Hemanth3247/Vector/Media/Rocket_avionics.jpeg

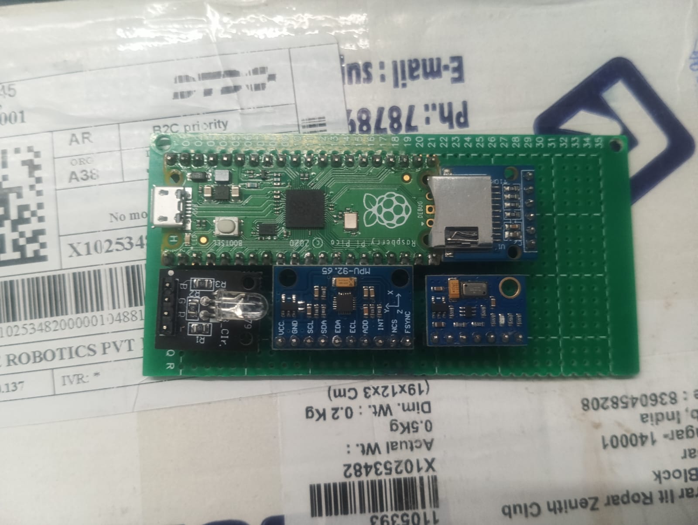
Media/Rocket_avionics.jpeg
