Hemanth3247/Vector/Documentation/Rocket Avionics SystemNew.docx

Rocket Avionics System

Microcontroller

A microcontroller is like the brain of the system it does all the tasks like sensors data reading, logging data, controlling modules, and control actuators. It does all the calculation and computation of the data being received. It integrates all the modules.

For an Avionics system due to multiple sensors and modules integrated we use a microcontroller with good clock speed for fast calculations due to continuous change in data, Hardware compatible since we use so many sensors and modules (We need to use a Microcontroller which supports all I2C,UART,SPI Protocols), good Memory since few modules give huge data, Low power consumption and Size & Weight the avionics system needs to be smaller and light weight so we can’t use big and heavy microcontrollers or sensors.

Model | Core, Clock speed &Data Processing | Memory | Hardware | Power | Size & weight | Price | To Buy
Raspberry Pi Pico RP2040 | Dual ARM Cortex-M0+ 133MHZ 32-bit | 264KB RAM 2MB Flash | I²C (2×), SPI (2×), UART (2×) 16 PWM ADC (12-bit, 3) PIO (Programmable I/O) for custom protocols | Input power: 1.8–5.5 V (SMPS) Operates at 3.3 V logic ~30–100 mA typical, max 300 mA | 21×51 mm, ~3g | ~ ₹350 | Link (https://robu.in/product/raspberry-pi-pico/)
Raspberry Pi Pico RP2350 | Dual ARM Cortex M33 150MHZ 32-bit | 512KB RAM 4MB Flash | I²C (2×), SPI (2×), UART (2×) 24 PWM ADC (12-bit, 3) PIO (Programmable I/O) for custom protocols | Input power: 1.8–5.5 V (SMPS) Operates at 3.3 V logic ~30–100 mA typical, max 300 mA | 51×21mm, ~4g | ~ ₹500 | Link (https://robu.in/product/raspberry-pi-pico-2/)
STM32F103CBT6 Blue pill | ARM Cortex-M3 72 MHz 32-bit | 20KB RAM 128KB Flash | I²C (2×), SPI (2×), UART (3×) 7 PWM ADC (12-bit, 10) | Input power: 4.5-7 V (AMS1117) Operates at 3.3 V logic ~20–50 mA typical, up to 150–300 mA | 53.4 mm × 22 mm ~3.3 g | ~ ₹350 | Link (https://robu.in/product/weact-studio-stm32f103cbt6-bluepill-plus-arm-stm32-minimum-system-development-board-module/)
ATmega328P Nano V3.0 CH340 | ATmega328P 16 MHz 8-bit | 2KB RAM 32 KB Flash 1 KB EEPROM | I²C (1×), SPI (1×), UART (1×) 6 PWM ADC: 10-bit, 8 | Input power: 7-12V (AMS1117) Operates at 5 V logic ~19 mA typical up to ~150–200 mA | 45 mm × 18 mm ~7 g | ~ ₹1900 | Link (https://robu.in/product/original-arduino-nano/)
Espressif ESP32-C3 | RISC-V single-core 160 MHz 32-bit | 400 KB RAM 4 MB Flash | I²C (2×), SPI (2×), UART (2×), PWM 6 ADC 12-bit 6 | Input power: 3-3.6 V (internal LDO) Operates at 3.3 V logic ~20–50 mA typical, up to 150–300 mA | 18 mm × 25.5 mm, ~3–4 g | ~ ₹900 | Link (https://robu.in/product/espressif-esp32-c3/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)
SmartElex ESP32-C6 (Wi-Fi 6, BLE 5.2) | RISC-V single-core 160 MHz 32-bit | 400 KB RAM 4 MB Flash | I²C (2×), SPI (2×), UART (2×), PWM 6 ADC 12-bit | Input power: 3-3.6 V (internal LDO) Operates at 3.3 V logic ~20–50 mA typical, up to 150–300 mA | ~25 mm × 18 mm, ~4 g | ~ ₹1150 | Link (https://robu.in/product/smartelex-esp32-c6-development-board-1-pcs/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)
ESP32-WROVER | Dual-core Xtensa LX6 240 MHz 32-bit | 520 KB RAM 4 MB Flash 8 MB PSRAM | I²C (2×), SPI (4×), UART (3×), PWM 16 ADC 12-bit 18 DAC 2× | Input power: 3-3.6 V (internal LDO) Operates at 3.3 V logic ~50–80 mA typical, up to 400–500 mA | ~18 mm × 25.5 mm, ~4 g | ~ ₹1650 | Link (https://robu.in/product/esp32-wroom-e-esp32-devkitc-core-board-for-arduino/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)
ESP32-S3 | Dual-core Xtensa LX7 240 MHz 32-bit AI (TInyML) | 512 KB RAM 4 MB Flash 8 MB PSRAM | I²C (2×), SPI (4×), UART (3×), PWM 16, ADC 12-bit 20 DAC 2× | Input power: 3-3.6 V (internal LDO) Operates at 3.3 V logic ~50–80 mA typical, up to 400–500 mA | ~18 mm × 25.5 mm, ~4 g | ~ ₹1400 | Link (https://robu.in/product/dfrobot-firebeetle-2-esp32-s3-n4-dual-core-iot-microcontroller-no-cam-4mb-fl-512kb-sr-supports-ai-acceleration/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)
Teensy 3.5 | ARM Cortex-M4 120 MHz 32-bit | 192 KB RAM 512 KB Flash | I²C (2×), SPI (3×), UART (3×), PWM 31 ADC: 13-bit, 25 | Input power: 3.6-6 V (AMS1117) Operates at 3.3 V logic ~ 20–60 mA typical, up to 200 mA | 61 mm × 18 mm, ~6 g | ~ ₹3300 | Link (https://robu.in/product/teensy-3-5-development-board/)
Teensy 3.6 | ARM Cortex-M4 180 MHz 32-bit | 256 KB RAM 1 MB Flash | I²C (3×), SPI (4×), UART (6×), PWM 58 channels ADC: 16-bit, 25 channels | Input power: 3.6-6 V (AMS1117) Operates at 3.3 V logic ~ 20–70 mA typical, up to 250 mA | 61 mm × 18 mm, ~6 g | ~ ₹3000 | Link (https://robu.in/product/teensy-3-6-development-board/)
Teensy 4.0 | ARM Cortex-M7 600 MHz 32-bit | 1024 KB RAM 2 MB Flash | I²C (3×), SPI (3×), UART (3×), PWM 31 ADC: 12-bit, 14 | Input power: 3.6-6 V (AMS1117) Operates at 3.3 V logic ~ 20–100 mA typical, up to 500 mA | 35.56 mm × 17.78 mm, ~3 g | ~ ₹2300 | Link (https://robu.in/product/teensy-4-0-development-board/)
Teensy 4.1 | ARM Cortex-M7 600 MHz 32-bit | 1024 KB RAM 8 MB Flash | I²C (3×), SPI (3×), UART (8×), PWM 31 ADC: 12-bit, 18 | Input power: 3.6-6 V (AMS1117) Operates at 3.3 V logic ~ 20–100 mA typical, up to 500 mA | 71.12 mm × 18.0 mm, ~8 g | ~ ₹2800 | Link (https://robu.in/product/buy-teensy-4-1-development-board/)

So based on the study, the above microcontrollers are suitable for a rocket as the main computer but in this project based on computation, price factors, and friendly level we have decided to use either raspberry pi Pico 1, 2 ESP32-C3, ESP32-WROVER, ESP32-S3, Teensy 4.0, 4.1.

For the current level of sensors, modules and range it is considered to use the raspberry pi Pico 1 or 2.

Battery

the battery is the main power because there’s no external power available it runs everything from flight computers to sensors and actuators. Without it, the avionics wouldn’t work at all.

Power | Current Draw | Battery Voltage | Capacity (mAh) | Use Case
Low | ≤100 mA | 3.7 V | 500–1000 | Microcontrollers, simple sensors, LED indicators
Medium | 100–500 mA | 3.7 V | 1000–2200 | Cameras, GPS, communication modules (low duration)
Medium | 100–500 mA | 7.2–7.4 V | 1000–2200 | Step-down via buck to 3.3 V for multiple sensors
High | >500 mA | 7.2–7.4 V | 2200–5000 | High-power sensors, actuators, multiple modules
High | >500 mA | 11.1 V | 2200–10000 | Step-down to 3.3 V / 5 V for heavy avionics load
Very High | >1 A | 11.1 V | 5000–15000 | Multiple high-current devices, long-duration flights
Very High | >1–2 A | 14.8 V | 5000–15000 | Multiple cameras, actuators, complex avionics
Extreme | >2–3 A | 22.2 V | 5000–20000 | Large experimental rockets, full avionics + actuators

Systems running at 3.3 V always need a buck converter if battery >3.7 V

Note: The higher voltage batteries are chosen when the load is high to:

- Prevent voltage sag
- Handle current spikes
- Avoid overheating or damaging components

For any system, choose a battery with voltage higher than the system’s operating voltage (drop it using a buck converter) and sufficient capacity/current rating to handle both continuous draw and peak spikes safely for long duration.

Sensors

Barometer

A sensor used to detect the surrounding pressure which is also used to detect height, also detects Temperature.

Based on analyzing few models, few sensors are more expensive and accurate but that level of accuracy is not needed for rocket avionics for a rocket which can go up to 1km+ height, so based on accuracy, resolution and price factors also it was observed most of the avionic system used this sensor as a barometer due to its accuracy and error values. I prefer the MS5611/BMP280 as the sensor in the Avionics, based on the model’s datasheet we could also try the BME280 but it was mostly not used in avionics system due to its noise and data rate. In between BMP280 and MS5611. The MS5611 is preferred as since the BMP280 is not designed for a fast-changing pressure its night give faulty data.

BMP280 – Cheap, accurate, good for general altitude/pressure

MS5611 – Chosen for high altitudes, fast-changing pressure

But for higher accuracy, fast response, filtered data it is preferred to use the BMP390, MS5607 or DPS368

Model | Pressure Range | Pressure Accuracy | Pressure Resolution OSR-pressure-height-time OSR-mbar-meter-ms | Price | To Buy
MS5611 | 10-1200 mbar | ±2.5mbar ±20 m | 256-0.065-0.54-0.54 512-0.042-0.35-1.06 1024-0.027-0.22-2.08 2048-0.018-0.15-4.13 4096-0.012-0.10-8.22 | ~ ₹500 | Link (https://robu.in/product/gy-63-ms5611-01ba03-high-precision-pressure-sensor-height-sensor-module/)
MS8607 | 10-2000 mbar | ±4mbar ±30 m | 256-0.11-0.90-0.54 512-0.062-0.51-1.06 1024-0.039-0.33-2.08 2048-0.028-0.23-4.13 4096-0.021-0.17-8.22 8192-0.016-0.13-16.44 | ~ ₹2800 | Link (https://robu.in/product/adafruit-ms8607-pressure-humidity-temperature-pht-sensor-stemma-qt-qwiicrohs-compliant/)
MS5607 | 10-1200 mbar | ±2.5mbar ±20 m | 256x - 0.13 - 1.08 - 0.48 512x - 0.084 - 0.70 - 0.95 1024x - 0.054 - 0.45 - 1.88 2048x - 0.036 - 0.30 - 3.72 4096x - 0.024 - 0.20 - 7.40 | ~ ₹2650 | Link (https://www.mouser.in/ProductDetail/Parallax/29124?qs=vI1DwPFGRq8hfmDGjOY2Mg%3D%3D)
BMP180 | 300-1100 mbar | ±4mbar ±30m | 256-0.13-0.94-4.5 512-0.08-0.60-7.5 1024-0.05-0.40-13.5 2048-0.04-0.30-25.5 4096-0.03-0.25-49.5 | ~ ₹50 | Link (https://robu.in/product/bmp180-digital-barometric-pressure-sensor-module/)
BME280 | 300-1100 mbar | ±1mbar ±10m | 1x-0.026-0.22-7 2x-0.013-0.11-7 4x-0.0066-0.055-7 8x-0.0033-0.028-7 16x-0.0018-0.015-7 | ~ ₹250 | Link (https://robu.in/product/gy-bme280-5v-temperature-and-humidity-sensor/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)
BMP280 | 300-1100 mbar | ±1mbar ±10m | 1x - 2.62 - 0.218 - 5.5 2x - 1.31 - 0.109 - 7.5 4x - 0.66 - 0.055 - 11.5 8x - 0.33 - 0.027 - 19.5 16x - 0.16 - 0.013 - 37.5 | ~ ₹50 | Link (https://robocraze.com/products/bmp280-sensor-module?variant=40192776274073&country=IN&currency=INR)
DPS368 (Sensor chip) | 300-1200 mbar | ±1mbar ±10m | 1x-3.20-0.267-3.6 2x-2.20-0.183-7.0 4x-1.60-0.133-14.0 8x-1.30-0.108-28.0 16x-1.00-0.083-27.6 32x-0.80-0.067-55.0 64x-0.60-0.050-110.0 | ~ ₹1050 | Link (https://www.industrybuying.com/switches-infineon-AUT.SWI.429782824)
BMP390 | 300-1200 mbar | ±0.5mbar ±5m | 1x-0.037-0.308-4.82 2x-0.027-0.225-6.84 4x-0.020-0.167-10.88 8x-0.016-0.133-18.69 16x-0.012-0.100-37.14 32x-0.009-0.075-69.46 | ~ ₹1400 | Link (https://evelta.com/adafruit-bmp390l-precision-barometric-pressure-and-altimeter-stemma-qt-qwiic/)

IMU (Inertial measurement unit)

A sensor with accelerometer and gyroscope detects 3-axis linear acceleration, 3-axis angular velocity and also the 3-axis orientation.

Model | DOF | Range | Price | To Buy
MPU-6050 | A-3 Axis G- 3 Axis | A- ± 2 ± 4 ± 8 ± 16 g G-± 250, 500, 1000, 2000 °/s | ~ ₹150 | Link (https://robu.in/product/mpu-6050-gyro-sensor-2-accelerometer/)
MPU6500 (Better version of MPU-6050) | A-3 Axis G- 3 Axis | A-± 2 ± 4 ± 8 ± 16g G-± 250 500 1000 2000 ° / s | ~ ₹300 | Link (https://robu.in/product/mpu6500-gyroscope-accelerometer-digital-motion-processor-dmp-6-axis-motion-sensor-with-i2c-spi-interface/)
MPU-9250 | A-3 Axis G- 3 Axis M-3 Axis | A-±2g, ±4g, ±8g, ±16g G-±250, ±500, ±1000, ±2000 °/s M-± 4800uT | ~ ₹800 | Link (https://robodo.in/products/mpu-9250-gy-9250-9-axis-sensor-module-i2c-spi-communications-thriaxis-gyroscope-and-accelerometer-magnetic-field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)
MPU-9255 | A-3 Axis G- 3 Axis M-3 Axis | A-±2g, ±4g, ±8g, ±16g G-±250, ±500, ±1000, ±2000 °/s M-± 1200uT | ~ ₹600 | Link (https://rees52.com/products/mpu-9255-gy-9255-3-5v-i2c-9do-attitude-sensor-compass-accelerator-gyro-module-rs1114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)
ICM-20948 | A-3 Axis G- 3 Axis M-3 Axis | A-±2g, ±4g, ±8g, ±16g G-±250, ±500, ±1000, ±2000 °/s M-± 4800uT | ~ ₹900 | Link (https://robocraze.com/products/icm-20948-9dof-imu-breakout-board-mpu-9250-upgrade-7semi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)
LSM9DS1 | A-3 Axis G- 3 Axis M-3 Axis | A-± 2 ± 4 ± 8 ± 16g G-± 250 500 1000 2000 ° / s M-±4, ±8, ±12, ±16 gauss | ~ ₹1500 | Link (https://robu.in/product/smartelex-9-dof-accel-mag-gyrotemp-breakout-board-lsm9ds1/)
LSM6DSOX | A-3 Axis G- 3 Axis | A-±2g, ±4g, ±8g, ±16g G-±250, ±500, ±1000, ±2000 °/s | ~ ₹1550 | Link (https://evelta.com/adafruit-lsm6dsox-6-dof-accelerometer-and-gyroscope/)
BNO085 | A-3 Axis G- 3 Axis M-3 Axis | A-±2g, ±4g, ±8g, ±16g G-±250, ±500, ±1000, ±2000 °/s M-± 4900uT | ~ ₹2700 | Link (https://robu.in/product/adafruit-9-dof-orientation-fusion-bno080-stemma-qt/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)
BNO055 | A-3 Axis G- 3 Axis M-3 Axis | A-±2g, ±4g, ±8g, ±16g G-±250, ±500, ±1000, ±2000 °/s M-± 4900uT | ~ ₹2000 | Link (https://robu.in/product/df-robot-febno055-intelligent-9-axis-sensor-rmion-bno055-intelligent-9-axis-sensor-breakout/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)

All the above sensors are of good resolution and accuracy but based on Error Values and price factors it is preferred to use the ICM20948 or MPU6500. The MPU have a DOF of 6 – Axis whereas the ICM have a DOF of 9 – Axis.

But for a high accuracy and fast response and for advanced algorithms integrated sensors it is preferred to use BNO085 or BNO055.

Modules

Camera Module

It is preferred to use a camera module to have a video of rocket throughout the flight to analyse the rocket and make proper changes in further launches. also to have a video from rocket point of view.

Module | Resolution | Frames per second | Price | To Buy
OV7670 | 640X480 | 30 | ~ ₹150 | Link (https://robu.in/product/ov7670-640x480-vga-cmos-camera-image-sensor-module/)
ArduCam OV5642 | 2592X1944 1920X1080 1280X720 640X480 320X420 | 15 30 60 60 120 | ~ ₹2700 | Link (https://robu.in/product/arducam-5-mega-pixel-camera-module-ov5642-1080p-jpeg-output/)
ArduCam OV2640 | 1600X1200 800X600 640X480 320X240 352X288 176X144 | 15 30 30 60 60 120 | ~ ₹3850 | Link (https://www.amazon.in/Arducam-Module-Megapixels-Arduino-Mega2560/dp/B012UXNDOY?s=electronics)

As of now based on resolution and price factors I prefer the OV7670.

To have a high FPS and clarity you can also use the OV5642 or OV2640.

MicroSD Card Module and Memory Card

It is preferred to use a MicroSD card and Memory card to store the data of pressure, altitude, temperature, 3-axis acceleration, 3-axis angular velocity, 3-axis Orientation throughout the flight also to store the recording of the camera module.

Module | Write/Read speed | price | To Buy
MicroSD Card Reader/Writer | Arduino UNO/Nano + SD library: 4–5 kB/s Arduino UNO/Nano + SdFat library + optimized SPI: 50-100 kB/s MCU like ESP32: 1–2 MB/s Raspberry Pi Pico (RP2040): 0.8–2.0 MB/s | ~ ₹50 | Link (https://robu.in/product/micro-sd-card-module/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)
Mini Micro SD Card Reader/Writer | Arduino UNO/Nano + SD library: 4–5 kB/s Arduino UNO/Nano + SdFat library + optimized SPI: 80-150 kB/s MCU like ESP32: you could reach 1–4 MB/s Raspberry Pi Pico (RP2040): 1.0–3.0 MB/s | ~ ₹25 | Link (https://robu.in/product/mini-micro-sd-card-reader-module/)
MicroSD Card | 11mb/s | ~ ₹300 | Link (https://www.flipkart.com/morebyte-ultra-plus-4gb-memory-card-class-10-transfer-speed-upto-100mb-s-4-gb-microsd-90-mb-s-compatible-camera-computer-mobile-table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)

The above module seems fine with the Avionics system since the data that to be stored is smaller.

LED Module

The LED module is used in the avionics as it emits light when it wants to give a signal related to parachute deployment, altitude rising or falling which can be useful since we always can’t connect it to the laptop or read the data.

It is preferred to use the RGB LED for multiple colours.

Module | Rating | Price | To Buy
XL-A504RGBC-XINGLIGHT-Plugin | 5V R-20mA, G-20mA, B-20mA 200mW | ~ ₹10 | Link (https://robu.in/product/xl-a504rgbc-xinglight-plugind5mm-rgb-leds-rohs/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)
DIP 3 Colour LED Module | 5v R-20mA, G-13mA, B-13mA 200mW | ~ ₹50 | Link (https://robu.in/product/dip-3-color-led-module/)

Voltage Regulator

A voltage regulator is a module which either Step-Up (only Buck converter) or Step-Down the input constant voltage. It is used on battery sources as input so we can Step-Down to desired voltage on which the microcontrollers, sensors, actuators work.

LDO (low dropout regulator) – uses a series variable resistor for voltage drop

Buck Converter – operates like the PWM pin with duty cycle to get average voltage.

Boost converter – operates just like Buck but also stores some energy in inductor/capacitor for Step-Up.

Module | Type | Rating | Price | To Buy
LM2596 | Buck | Input: 3-40V Output: 1.5-35V 2 A Rating, 3 A peak Freq-150KHz, Efficiency-92% | ~ ₹40 | Link (https://robu.in/product/lm2596s-dc-dc-buck-converter-power-supply/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)
MP1584 | Buck | Input Voltage: 4.5V – 28V Output Voltage: 0.8V – 20V 1.8 A Rating, 3 A peak Freq- 1.5 MHz, Efficiency-92% | ~ ₹40 | Link (https://robu.in/product/mini-mp1584-dc-dc-3a-adjustable-buck-module-india/)
AMS1117 5V | LDO | Input: DC 6.5V – 12V Output: 5.0V ± 0.05v Output Current: 800mA | ~ ₹15 | Link (https://robu.in/product/ams1117-3-3-ldo-800ma-dc-5v-3-3v-step-power-supply-module/)
AMS1117 3.3V | LDO | Input: 4.5V to 15V Output: 3.3V ± 0.05v Output Current: 800mA | ~ ₹25 | Link (https://robu.in/product/ams1117-3-3-ldo-800ma-dc-5v-3-3v-step-power-supply-module/)

The LDO’s are smaller and cheaper but the avionics system current is usually higher than the rating of the LDO so we can only use the buck converter.

We can use either MP1584 or LM2596 but the MP1584 is smaller and efficient whereas the range and rating of LM2596 are higher. Since in the Avionics the used voltage is less than the range it is preferred to use the MP1584.

SWITCH

In order to save battery and also to not continuously run the system we are supposed to use a switch. It can be placed between battery positive terminal and the Buck input positive terminal.

Model | Type | Rating | price | To Buy
DS-429-Game Switch Starter Push Latching Button (ON-OFF) | Latch Push-Button | 3A 125VAC/1.5 A 250VAC | ~ ₹16 | Link (https://robu.in/product/ds-429-game-switch-starter-push-latching-buttonon-off/)
DS-211K-SPST Push Button Latching Switch-2 Pin (ON-OFF) | Latch Push-Button | 1.5A 250VAC | ~ ₹20 | Link (https://robu.in/product/ds-211k-spst-push-button-latching-switch-2pinoff-on/)
PBS-03A-SMD Push Button Latching Switch (ON-OFF) | Latch Push-Button | 3A 250VAC | ~ ₹20 | Link (https://robu.in/product/pbs-03a-smd-push-button-latching-switchon-off/)

For the Current project we have decided the below components to use for the avionics system

Component | Model | Price | To Buy
Microcontroller | Raspberry Pi Pico RP2040 | ~ ₹350 | Link (https://robu.in/product/raspberry-pi-pico/)
Battery | WLY802040 3.7V 600mAh 1S LiPo Battery | ~ ₹200 | Link (https://robu.in/product/wly802040-600mah-3-7v-single-cell-rechargeable-lipo-battery/?gad_source=1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)
Barometric Sensor | MS5611 | ~ ₹500 | Link (https://robu.in/product/gy-63-ms5611-01ba03-high-precision-pressure-sensor-height-sensor-module/)
Inertial measurement unit | MPU6500 | ~ ₹300 | Link (https://robu.in/product/mpu6500-gyroscope-accelerometer-digital-motion-processor-dmp-6-axis-motion-sensor-with-i2c-spi-interface/)
Camera Module | OV7670 | ~ ₹150 | Link (https://robu.in/product/ov7670-640x480-vga-cmos-camera-image-sensor-module/)
SD Card Module | Mini Micro SD Card Reader/Writer | ~ ₹25 | Link (https://robu.in/product/mini-micro-sd-card-reader-module/)
RGB LED | DIP 3 Colour LED Module | ~ ₹36 | Link (https://robu.in/product/dip-3-color-led-module/)
Voltage Regulator | MP1584 | ~ ₹40 | Link (https://robu.in/product/mini-mp1584-dc-dc-3a-adjustable-buck-module-india/)
Switch | DS-429- Switch (ON-OFF) | ~ ₹16 | Link (https://robu.in/product/ds-429-game-switch-starter-push-latching-buttonon-off/)

Circuit

Power Supply

- The battery feeds into a buck converter, set to 3.3 V output.
- Buck OUT+ → DS-429 latching switch (acts as the master ON/OFF).
- DS-429 output → Pico 3V3 pin and all module VCC rails.
- Buck OUT– → common GND (connects to Pico GND and all module GNDs).

Buck Converter

- The battery feeds into a buck converter, adjusted to 3.3 V output.
- Buck OUT+ → DS-429 switch
- Buck OUT– → GND (this is the common ground for everything)

Sensors (I2C bus)

- Power: VCC → 3.3 V, GND → GND.
- MS5611 (barometer): VCC → 3.3 V, GND → GND, SDA → GP0, SCL → GP1.
- MPU6500 (IMU): VCC → 3.3 V, GND → GND, SDA → GP0, SCL → GP1. (Both share I2C bus on GP0–GP1.)

OV7670 Camera

- Power: VCC → 3.3 V, GND → GND
- Config (SCCB): SDA → GP2, SCL → GP3.
- Data bus: D0–D7 → GP4–GP11.
- Sync & clock: VSYNC → GP12, HREF → GP13, PCLK → GP14, XCLK (from Pico PWM) → GP15.
- Control: RST pulled HIGH, PWDN pulled LOW (can also connect to GPIOs if you want control).

SD Card Module (SPI)

- Power: VCC → 3.3 V, GND → GND.
- CS → GP17, SCK → GP18, MOSI → GP19, MISO → GP16.
- VCC → 3.3 V, GND → GND.

RGB LED (Common Cathode)

- Cathode → GND.
- R → GP28.
- G → GP27.
- B → GP26
- (If the LED doesn’t have inbuilt resistors add 220 Ω per terminal)

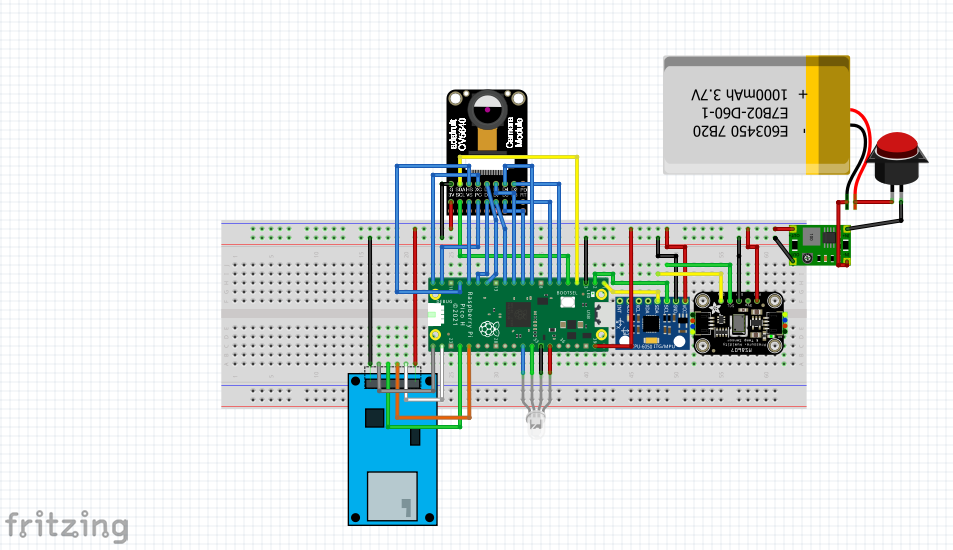
[picture p2: figure]

Note: In above circuit due to unavailability of MS5611, OV7670, MPU6500 fritzing parts different models of similar pins are used in the circuit. For original components u can still follow the above circuit.
