Hemanth3247/Vector/Media/AvionicsCircuit_with_Motor.png

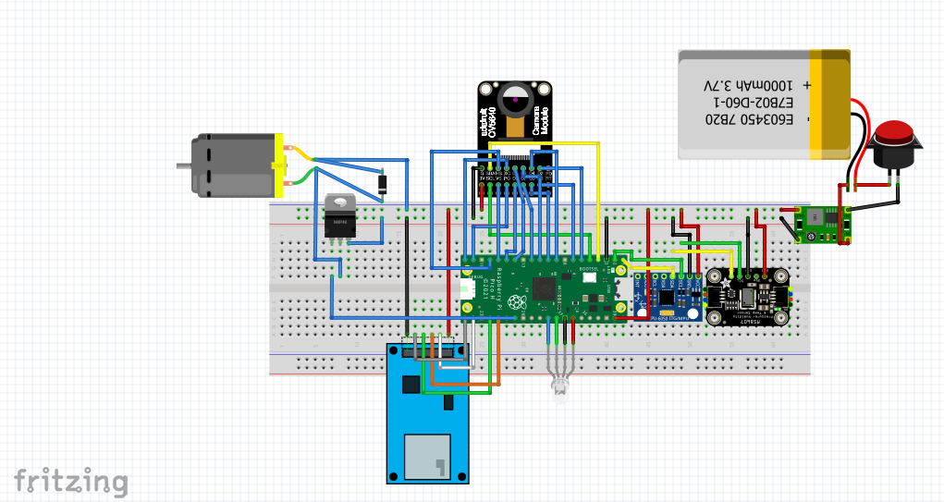
Media/AvionicsCircuit_with_Motor.png
