Hemanth3247/Vector/Media/Logic.png

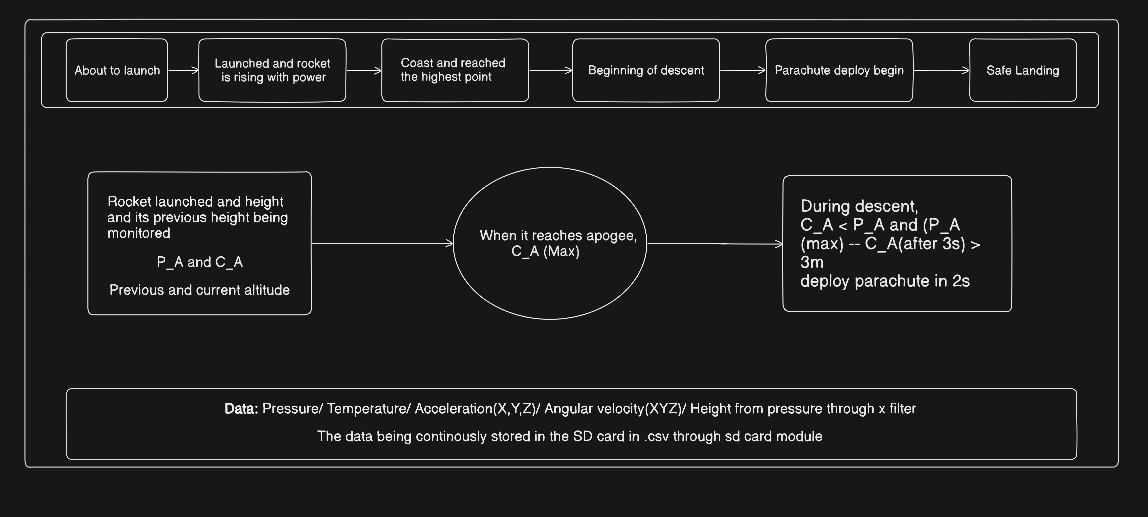
Media/Logic.png
