Hemanth3247/Vector/CAD_Designs/version2/Assem1.SLDASM

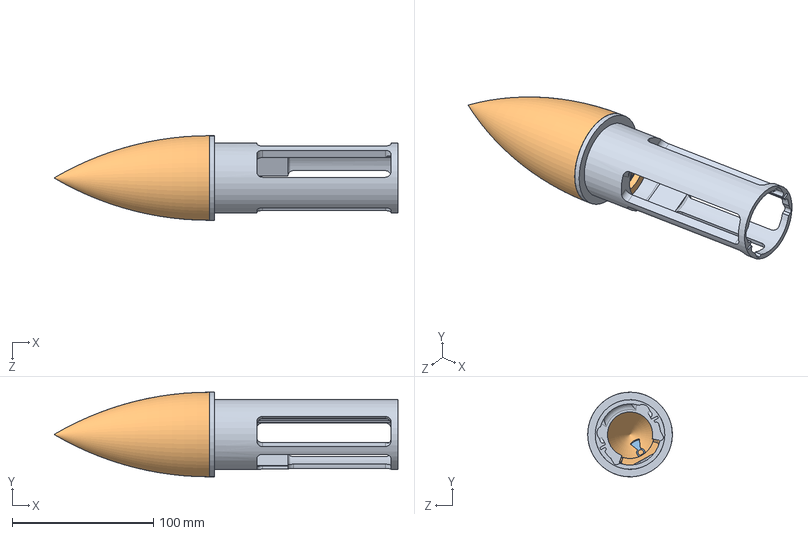
[picture p5: CAD file, 2026-06-23]
CAD_Designs/version2/Assem1.SLDASM
243.6 x 60.0 x 60.0 mm
NoseCone_Base
NoseCone_BottomHook
N20motor
