Hemanth3247/Vector/CAD_Designs/version2/NoseCone_Base.SLDPRT

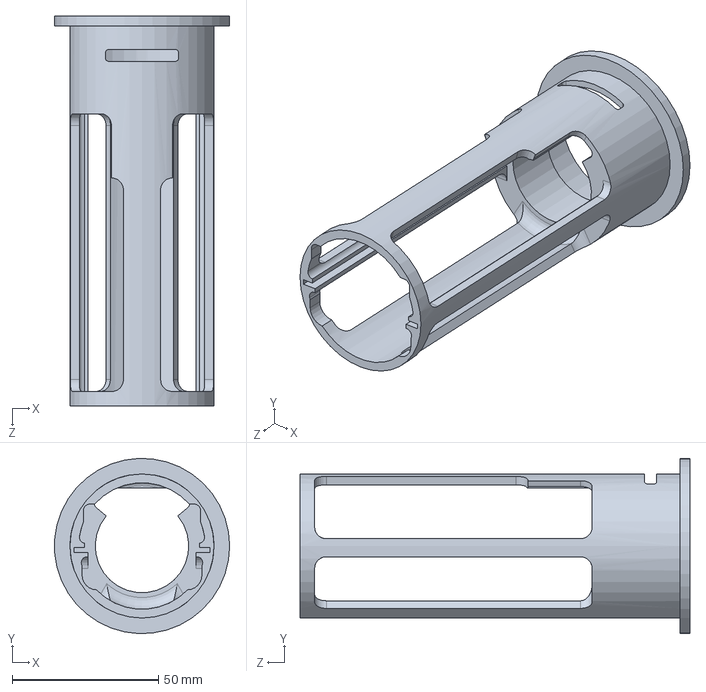
[picture p6: CAD file, 2026-06-23]
CAD_Designs/version2/NoseCone_Base.SLDPRT
60.0 x 60.0 x 133.5 mm
