Hemanth3247/Vector/CAD_Designs/version2/NoseCone_BottomHook.SLDPRT

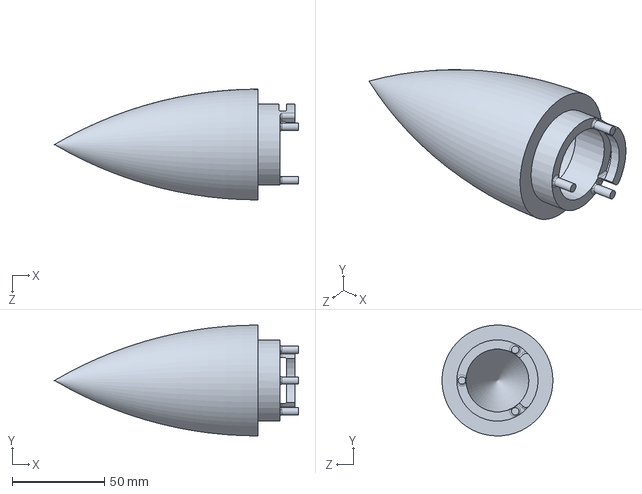
[picture p7: CAD file, 2026-06-23]
CAD_Designs/version2/NoseCone_BottomHook.SLDPRT
132.0 x 60.0 x 60.0 mm
