Hemanth3247/Vector/CAD_Designs/version2/N20motor.SLDPRT

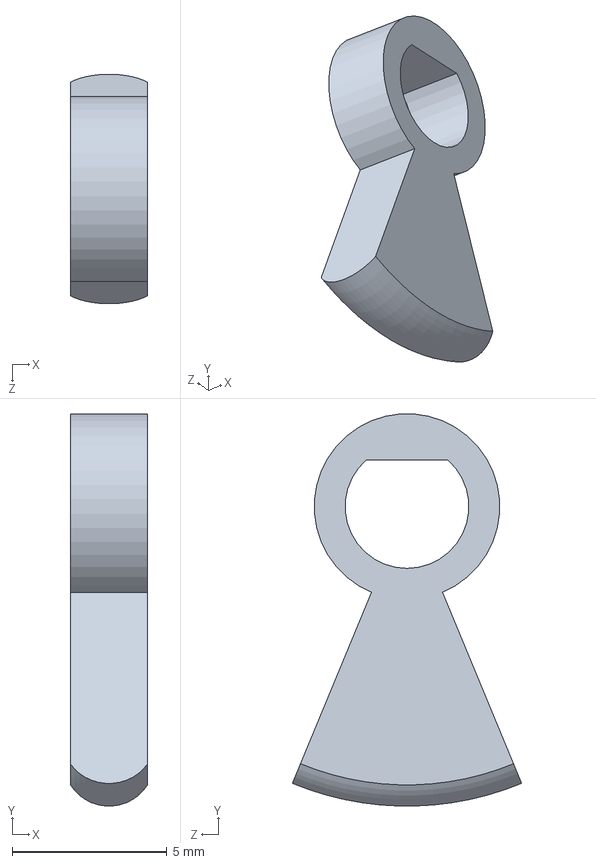
[picture p8: CAD file, 2026-06-23]
CAD_Designs/version2/N20motor.SLDPRT
2.50 x 12.7 x 7.41 mm
