Hemanth3247/Vector/CAD_Designs/version2/Avionics_Container2.SLDPRT

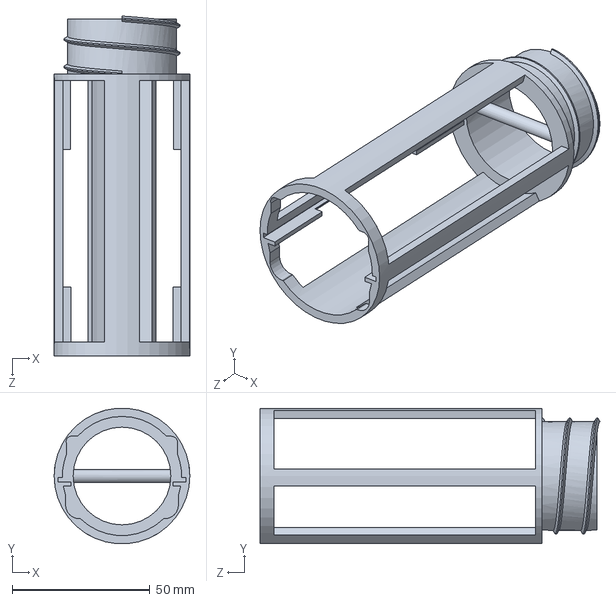
[picture p9: CAD file, 2026-06-23]
CAD_Designs/version2/Avionics_Container2.SLDPRT
49.3 x 49.1 x 123.5 mm
