Hemanth3247/Vector/CAD_Designs/version1/tl.SLDASM

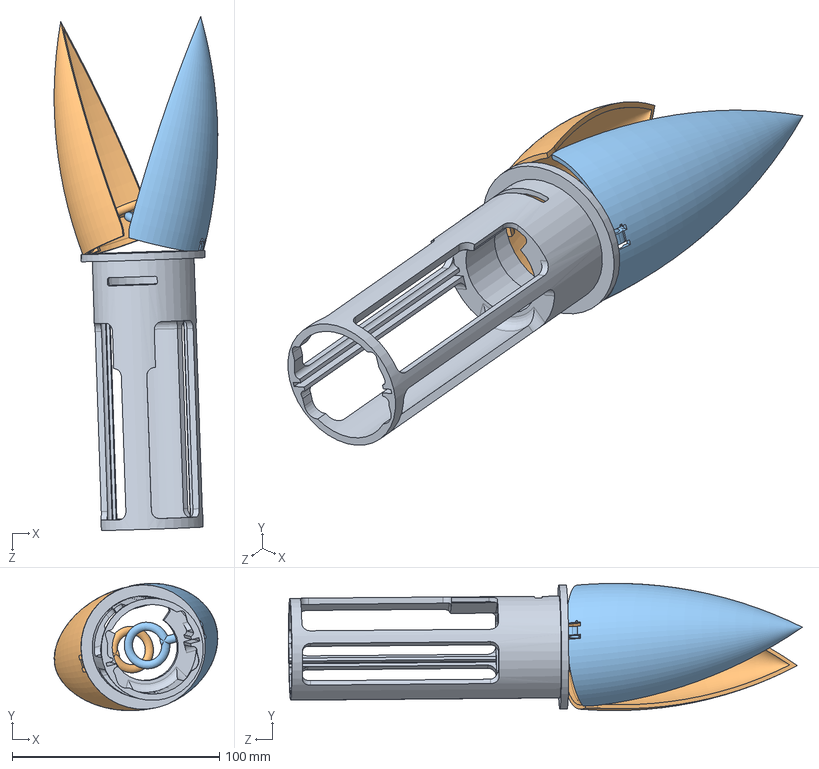
[picture p10: CAD file, 2026-06-23, an earlier design]
CAD_Designs/version1/tl.SLDASM
79.0 x 61.5 x 248.2 mm
NoseCone_Base
NoseCone_TopHook
NoseCone_BottomHook
