Hemanth3247/Vector/CAD_Designs/version1/Assem1.SLDASM

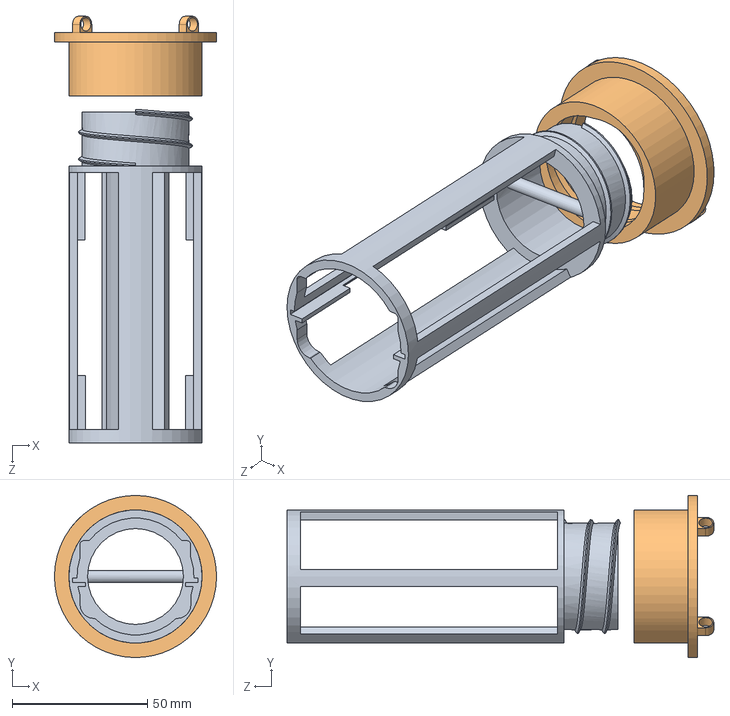
[picture p11: CAD file, 2026-06-23, an earlier design]
CAD_Designs/version1/Assem1.SLDASM
60.0 x 60.0 x 157.9 mm
Avionics_Container2
NoseCone_Base
