Hemanth3247/Vector/CAD_Designs/version1/EjectionSystem.SLDASM

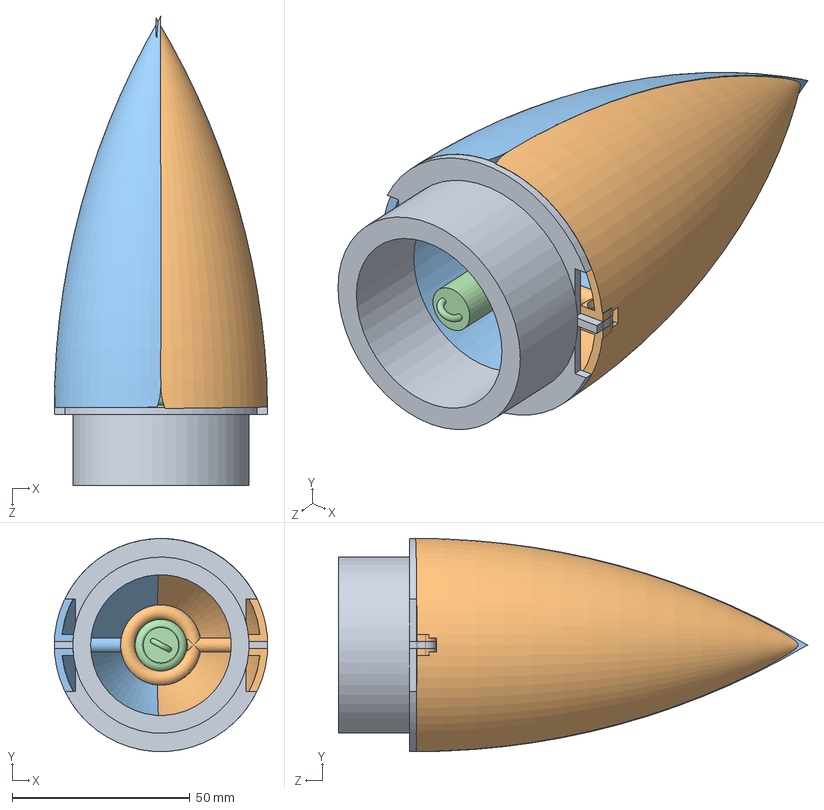
[picture p12: CAD file, 2026-02-03, an earlier design]
CAD_Designs/version1/EjectionSystem.SLDASM
60.1 x 60.0 x 132.0 mm
NoseCone_Base
NoseCone_TopHook
NoseConeRod
