Hemanth3247/Vector/CAD_Designs/version1/trialpart.STL

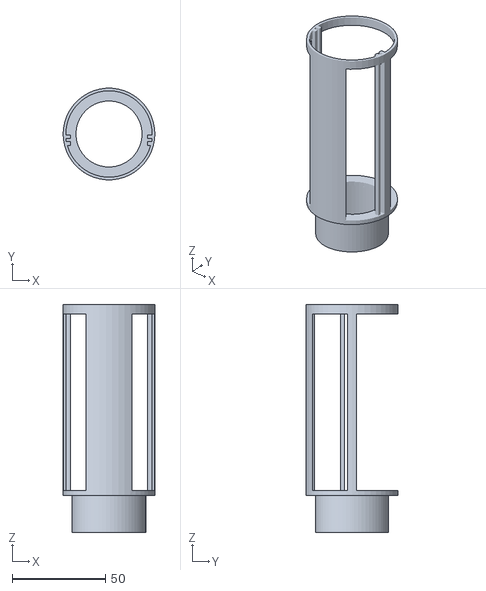
[picture p13: CAD file, 2026-06-23, an earlier design]
CAD_Designs/version1/trialpart.STL
49.3 x 49.2 x 122.5
