Hemanth3247/Vector/CAD_Designs/version1/AvionicsCap.SLDPRT

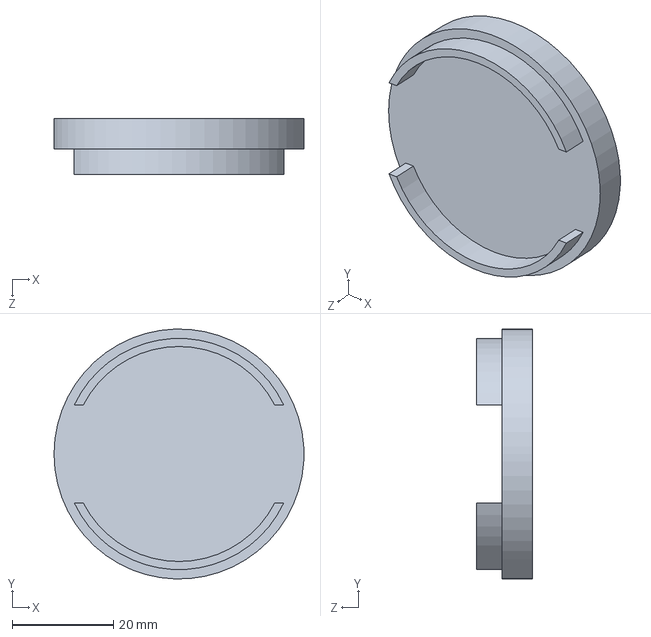
[picture p14: CAD file, 2026-06-23, an earlier design]
CAD_Designs/version1/AvionicsCap.SLDPRT
49.3 x 49.3 x 11.0 mm
