Hemanth3247/Vector/CAD_Designs/version1/teststand.SLDPRT

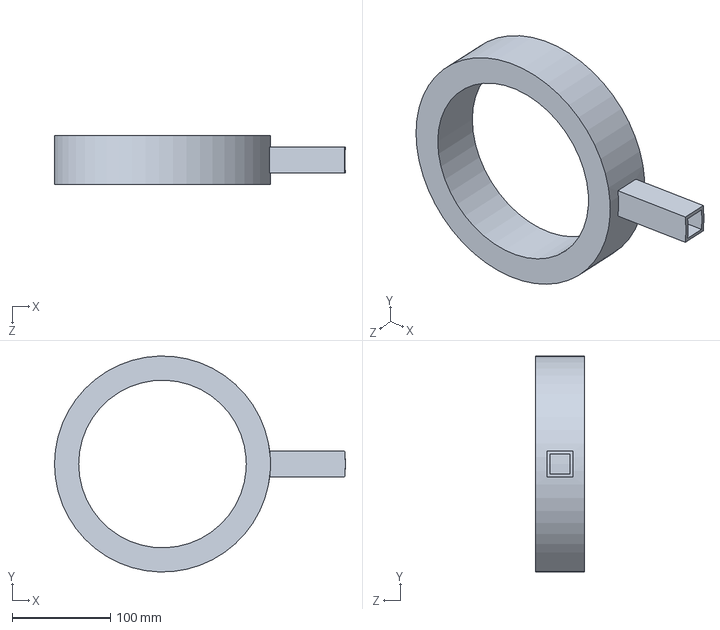
[picture p15: CAD file, 2026-06-23, an earlier design]
CAD_Designs/version1/teststand.SLDPRT
295.6 x 219.3 x 50.0 mm
