Hemanth3247/Vector/CAD_Designs/version1/NoseCone_TopHook.SLDPRT

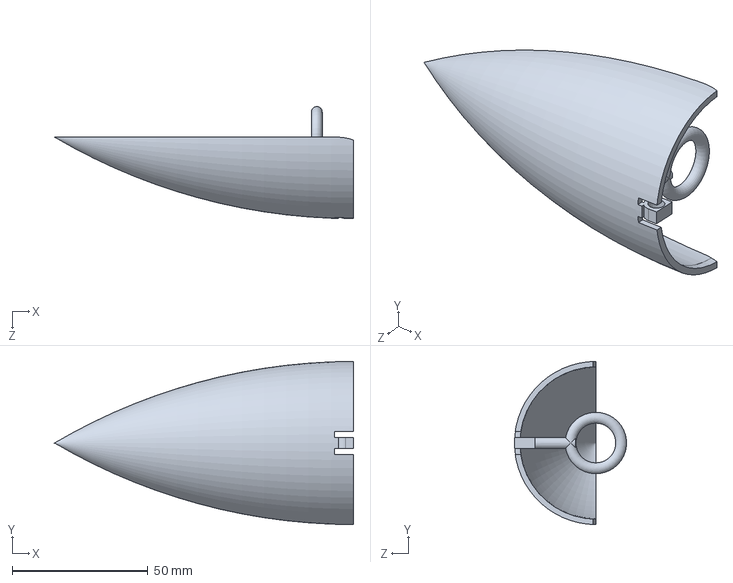
[picture p16: CAD file, 2026-06-23, an earlier design]
CAD_Designs/version1/NoseCone_TopHook.SLDPRT
110.0 x 60.0 x 41.2 mm
