Hemanth3247/Vector/CAD_Designs/version1/NoseCone_Base.SLDPRT

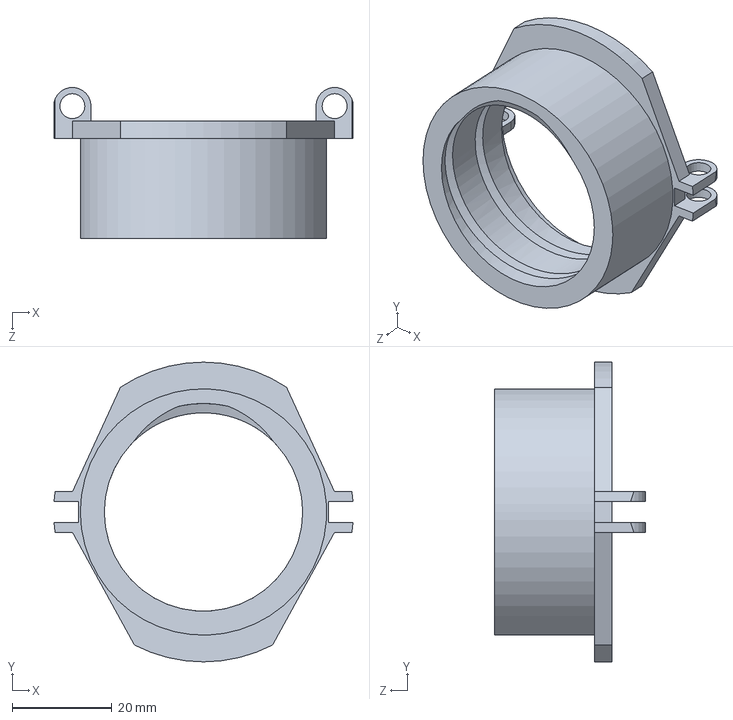
[picture p17: CAD file, 2026-06-23, an earlier design]
CAD_Designs/version1/NoseCone_Base.SLDPRT
59.9 x 60.0 x 30.2 mm
