Hemanth3247/Vector/CAD_Designs/version1/Avionics_Container.SLDPRT

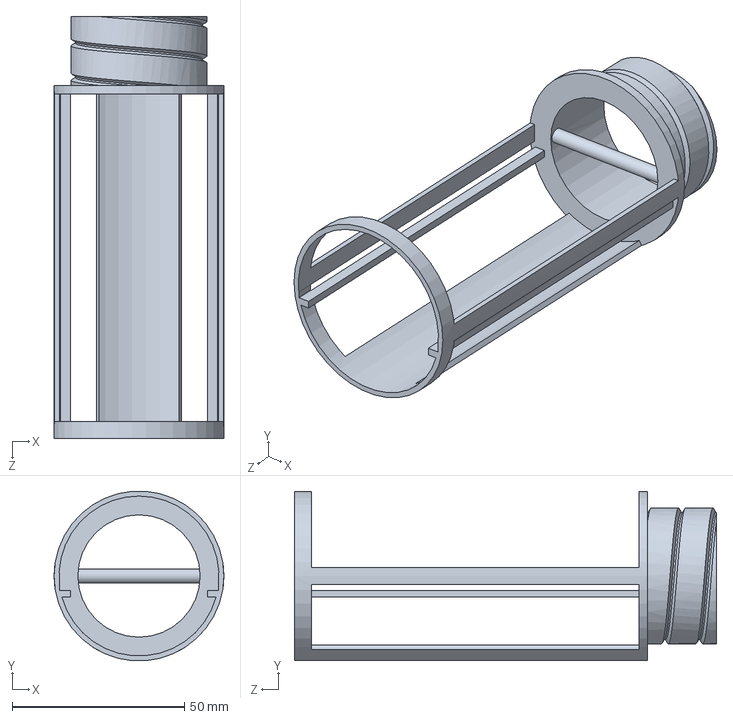
[picture p18: CAD file, 2026-06-23, an earlier design]
CAD_Designs/version1/Avionics_Container.SLDPRT
49.3 x 49.1 x 122.5 mm
