Hemanth3247/Vector/CAD_Designs/version1/NoseConeRod.SLDPRT

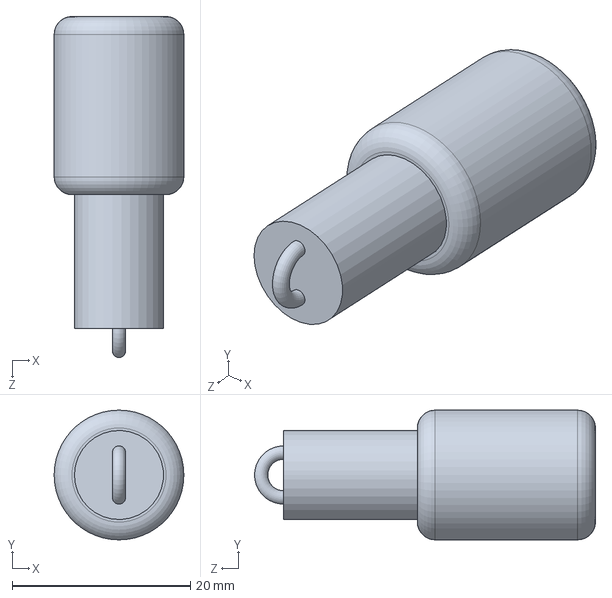
[picture p19: CAD file, 2026-02-03, an earlier design]
CAD_Designs/version1/NoseConeRod.SLDPRT
14.6 x 14.6 x 38.3 mm
