Hemanth3247/Vector/(list of files, cad)

Other CAD files:
CAD_Designs/version1/Avionics_Container2.SLDPRT
CAD_Designs/version1/AvionicsCap1.SLDPRT
CAD_Designs/version1/NoseCone_BottomHook.SLDPRT
CAD_Designs/version1/Avionics_Container.STL
CAD_Designs/version1/Avionics_Container2.STL
CAD_Designs/version2/N20motor.STL
CAD_Designs/version2/NoseCone_Base.STL
CAD_Designs/version2/NoseCone_BottomHook.STL
