Hemanth3247/Vector/(list of files, drawings)

Other design files:
CAD_Designs/version1/Avionics_Circuit.fzz
