Hemanth3247/Vector/(commit log)

2026-01-10 Ejection system deign 1
    [EjectionSystem.SLDASM, NoseCone_Base.SLDPRT, NoseCone_BottomHook.SLDPRT, NoseCone_TopHook.SLDPRT]
2026-02-01 Ejection cone
    [Avionics_Circuit.fzz, Avionics_Container.SLDPRT, EjectionSystem.SLDASM, NoseCone_Base.SLDPRT, NoseCone_BottomHook.SLDPRT, NoseCone_TopHook.SLDPRT]
2026-02-01 All drivers set
2026-02-03 cad and code updated1
    [AvionicsCap.SLDPRT, Avionics_Circuit.fzz, Avionics_Container.SLDPRT, EjectionSystem.SLDASM, NoseConeRod.SLDPRT, NoseCone_Base.SLDPRT]
2026-02-16 Pin adjustment
    [AvionicsCap.SLDPRT, Avionics_Container.SLDPRT]
2026-06-23 ejection system design update
    [Assem1.SLDASM, AvionicsCap.SLDPRT, AvionicsCap1.SLDPRT, Avionics_Circuit.fzz, Avionics_Container.SLDPRT, Avionics_Container.STL, Avionics_Container2.SLDPRT, Avionics_Container2.STL]
